Vapi27/GottFA80_PLuS/lib_common/R6532.vhd

-------------------------------------------------------------------------------
-- File       : R6532.vhd
-- Author     : Thierry DAVROUX
-- Company    : Flipprojets
-- Created    : 12-01-2017
-------------------------------------------------------------------------------
-- Description: Version simplifiee d'un 6532.
--              Avec uniquement les ports A et B et le timer.
--              La RAM et la ROM ne sont pas integrees dans ce module.
--              La selection est simplifiee avec un seul "Chip Select".
--              Detection de front sur PA7.
--              Bus d'adresses sur 5 bits (A4..A0).
-------------------------------------------------------------------------------
-- Copyright (c) Flipprojets François et Thierry DAVROUX - 2018
--               (contact@flipprojets.fr)
--
-- Concédée sous licence EUPL, version 1.2 ou – dès leur approbation par la
-- Commission européenne - versions ultérieures de l’EUPL (la «Licence»).
-- Vous ne pouvez utiliser la présente œuvre que conformément à la Licence.
-- Vous pouvez obtenir une copie de la Licence à l’adresse suivante:
--
-- https://joinup.ec.europa.eu/software/page/eupl
--
-- Sauf obligation légale ou contractuelle écrite, le logiciel distribué sous
-- la Licence est distribué «en l’état», SANS GARANTIES OU CONDITIONS QUELLES
-- QU’ELLES SOIENT, expresses ou implicites. Consultez la Licence pour les
-- autorisations et les restrictions linguistiques spécifiques relevant de la
-- Licence. 
-------------------------------------------------------------------------------
-- Revisions  :
-- Date        Version  Author   Description
-- 12-01-2017  1.0      TDX      Creation
-- 27-03-2017  1.1      TDX      Correction bug detection front PA7
-------------------------------------------------------------------------------

library  IEEE ;
use      IEEE.std_logic_1164.all ;
use      IEEE.numeric_std.all ;

entity  R6532 is
        port (
            phi2   : in  std_logic                     ; -- PHI2     horloge
            rst_n  : in  std_logic                     ; -- RST      reset negatif
            cs     : in  std_logic                     ; -- CS       chip select
            rw_n   : in  std_logic                     ; -- RW       read/write
            irq_n  : out std_logic                     ; -- IRQ      interruption
            
            add    : in  std_logic_vector (4 downto 0) ; -- A4..A0   Bus d'adresses
            din    : in  std_logic_vector (7 downto 0) ; -- DI7..DI0 Bus de donnees (entrees)
            dout   : out std_logic_vector (7 downto 0) ; -- DO7..DO0 Bus de donnees (sorties)
            
            pa_in  : in  std_logic_vector (7 downto 0) ; -- PORT A   entrees
            pa_out : out std_logic_vector (7 downto 0) ; -- PORT A   sorties
            pb_in  : in  std_logic_vector (7 downto 0) ; -- PORT B   entrees
            pb_out : out std_logic_vector (7 downto 0) ; -- PORT B   sorties

            -- ORA WRITE STROBE (added 2026-07-27 for SOUND_WIRE).  '1' for exactly
            -- the phi2-LOW half-cycle that follows a CPU write to ORA (register 0),
            -- i.e. it is high precisely while pa_out carries the value that write
            -- just produced -- pa_out is updated on the same falling_edge(phi2).
            -- This is the hardware strobe PinMAME uses (gts80.c riot6532_2a_w runs
            -- ONLY on a port-A write); without it a consumer of pa_out cannot tell
            -- "the CPU wrote the port" from "some other latch in the system moved".
            -- Purely additive: leave it unconnected (=> open) and it prunes away.
            -- A 6502 needs >= 3 phi2 cycles between two stores, so consecutive ORA
            -- writes always give separate pulses with a low phase in between.
            pa_wr  : out std_logic := '0'
        );
end entity;

architecture RTL of R6532 is

            signal s_ddra               : std_logic_vector (7 downto 0) ; -- Registre DDRA
            signal s_ddrb               : std_logic_vector (7 downto 0) ; -- Registre DDRB
            signal s_ora                : std_logic_vector (7 downto 0) ; -- Registre ORA
            signal s_orb                : std_logic_vector (7 downto 0) ; -- Registre ORB
            
            signal s_dout               : std_logic_vector (7 downto 0) ; -- Sortie du bus de donnees
            
            signal s_irq_timer          : std_logic                     ; -- Etat de l'interruption par le timer
            signal s_irq_timer_en       : std_logic                     ; -- Autorisation interruption par le timer
            signal s_divider            : unsigned (9 downto 0)         ; -- Prediviseur             (valeur maxi)
            signal s_count              : unsigned (9 downto 0)         ; -- Compteur du prediviseur (compteur)
            signal s_timer              : unsigned (7 downto 0)         ; -- Decompteur du timer     (valeur en cours)

            signal s_irq_pa7            : std_logic                     ; -- Etat de l'interruption par PA7
            signal s_irq_pa7_en         : std_logic                     ; -- Autorisation interruption par PA7
            signal s_edge               : std_logic                     ; -- Detection front sur PA7 (0 negatif, 1 positif)
            signal s_PA7                : std_logic                     ; -- Etat du PA7 memorise, pour detection front
            signal s_ora_wr             : std_logic := '0'              ; -- Ecriture dans ORA lors du dernier front montant de PHI2

begin

    ------------------------------------------------------------------------
    -- Fonctionnement principal dependant de PHI2
    ------------------------------------------------------------------------
    
    process(phi2)
    begin
    
        if (rising_edge(phi2)) then

            ------------------------------------------------------------------------
            -- Tout le circuit fonctionne sur front montant du PHI2
            -- y compris la prise en compte du RESET
            ------------------------------------------------------------------------

            s_ora_wr <= '0' ;                          -- defaut: pas d'ecriture ORA ce cycle

            if (rst_n = '0') then
            
                ------------------------------------------------------------------------
                -- RESET, init de la sortie de donnees et des ports A/B
                ------------------------------------------------------------------------
                s_dout          <= (others => '1')         ; -- Sortie FF
                s_ddra          <= (others => '0')         ; -- DDRA a zero
                s_ddrb          <= (others => '0')         ; -- DDRB a zero
                s_ora           <= (others => '0')         ; --  ORA a zero
                s_orb           <= (others => '0')         ; --  ORB a zero
                
                ------------------------------------------------------------------------
                -- RESET, init du timer/diviseur et du flag d'interruption
                ------------------------------------------------------------------------
                s_timer         <= (others => '0')         ; -- Remise a zero du decompteur du timer
                s_divider       <= "0000000000"            ; -- Remise a zero du prediviseur (mode 1T)
                s_count         <= (others => '0')         ; -- Remise a zero du compteur du prediviseur
                s_irq_timer     <= '0'                     ; -- Remise a zero de l'interruption
                s_irq_timer_en  <= '0'                     ; -- Interruption non autorisee
                
                ------------------------------------------------------------------------
                -- RESET, init du pa7 et du flag d'interruption
                ------------------------------------------------------------------------
                s_irq_pa7       <= '0'                     ; -- Remise a zero de l'interruption
                s_irq_pa7_en    <= '0'                     ; -- Interruption non autorisee
                s_edge          <= '0'                     ; -- Detection sur front negatif par defaut
            
            else
            
                ------------------------------------------------------------------------
                -- Traitement du timer, sur front montant du PHI2
                ------------------------------------------------------------------------
  
                if (s_count = s_divider) then
                    s_timer    <= s_timer - 1              ; -- On decremente le timer
                    s_count    <= (others => '0')          ; -- et on reinitialise le compteur du prediviseur
                    if (s_timer = "00000000") then           -- Si le timer est arrive a zero
                        s_divider   <= "0000000000"        ; --    on remet le diviseur a 1T
                        s_irq_timer <= '1'                 ; --    et on leve le flag d'interruption
                    end if ; 
                else
                    s_count <= s_count + 1                 ; -- On incremente le compteur du prediviseur
                end if ;
                
                ------------------------------------------------------------------------
                -- Traitement du PA7, sur front montant du PHI2
                ------------------------------------------------------------------------
  
                if (not(pa_in(7) = s_PA7)) then              -- Changement d'etat par rapport au dernier etat memorise
                    if (pa_in(7) = s_edge) then              -- Detection du front positif ou negatif selon programmation
                        s_irq_pa7 <= '1'                   ; -- Si oui, on leve le flag d'interruption pour PA7                        
                    end if ;
                end if ;
                s_PA7 <= pa_in(7)                          ; -- Memorisation de l'etat actuel du PA7
                
                ------------------------------------------------------------------------
                -- Acces aux registres, sur front montant du PHI2
                ------------------------------------------------------------------------
            
                if (cs = '1') then
                    -------------------------------------------------------------------------------
                    -- A condition que le CHIP SELECT soit actif, l'adressage est le suivant :   --
                    -- RW  xx000 - Read/Write    ORA                                             --  
                    -- RW  xx001 - Read/Write   DDRA                                             --
                    -- RW  xx010 - Read/Write    ORB                                             --
                    -- RW  xx011 - Read/Write   DDRB                                             --
                    --  W  1.100 - Write Timer    1T                                             --
                    --  W  1.101 - Write Timer    8T                                             --
                    --  W  1.110 - Write Timer   64T                                             --
                    --  W  1.111 - Write Timer 1024T                                             --
                    --  W  0x1.. - Write Edge Detect Control                                     --
                    -- R   xx1x0 - Read Timer                                                    --
                    -- R   xx1x1 - Read Status (interrupt flag)                                  --
                    -------------------------------------------------------------------------------
                
                    if (rw_n = '0') then
                        --------------
                        -- Ecriture --
                        --------------                  

                        if (add(2) = '0') then
                            ---------------------------------------------
                            -- Acces aux registres I/O    quand A2 = 0 --
                            ---------------------------------------------

                            case add(1 downto 0) is                       
                                when "00" =>
                                    ------------------------------
                                    -- 000 : Ecriture dans ORA  --
                                    ------------------------------
                                    s_ora    <= din ;
                                    s_ora_wr <= '1' ;   -- strobe d'ecriture ORA (voir port pa_wr)
                                when "01" =>
                                    ------------------------------
                                    -- 001 : Ecriture dans DDRA --
                                    ------------------------------
                                    s_ddra <= din ;
                                when "10" =>
                                    ------------------------------
                                    -- 010 : Ecriture dans ORB  --
                                    ------------------------------
                                    s_orb <= din ;
                                when "11" =>
                                    ------------------------------
                                    -- 011 : Ecriture dans DDRB --
                                    ------------------------------
                                    s_ddrb <= din ;
                                when others =>
                                    null ;
                            end case ;
                                
                        else
                            -------------------------------------------------
                            -- Acces aux registres Timer/Edge quand A2 = 1 --
                            -------------------------------------------------

                            if (add(4) = '1') then
                                ---------------------------------------------
                                -- Acces au timer/prediviseur quand A4 = 1 --
                                ---------------------------------------------

                                ---------------------------------------------
                                -- A3 active ou non les interruptions      --
                                ---------------------------------------------
                                
                                s_irq_timer_en <= add(3)     ; -- Autorisation des interruptions selon le bit A3
                                s_irq_timer    <= '0'        ; -- Efface le flag d'interruption
                                s_timer <= unsigned(din) - 1 ; -- Valeur initiale du timer
                                s_count <= (others => '0')   ; -- Mise a zero du compteur du prediviseur
                                    
                                case add(1 downto 0) is                          
                                    when "00" =>
                                        --------------------------
                                        -- 100 : diviseur    1T --
                                        --------------------------
                                        s_divider <= "0000000000" ; -- Valeur maxi du compteur = 0
                                    when "01" =>
                                        --------------------------
                                        -- 101 : diviseur    8T --
                                        --------------------------
                                        s_divider <= "0000000111" ; -- Valeur maxi du compteur = 7
                                    when "10" =>
                                        --------------------------
                                        -- 110 : diviseur   64T --
                                        --------------------------
                                        s_divider <= "0000111111" ; -- Valeur maxi du compteur = 63
                                    when "11" =>
                                        --------------------------
                                        -- 111 : diviseur 1024T --
                                        --------------------------
                                        s_divider <= "1111111111" ; -- Valeur maxi du compteur = 1023
                                    when others =>
                                        null ;
                                end case ;
                                
                            else
                                ---------------------------------------------
                                -- Acces au Edge              quand A4 = 0 --
                                ---------------------------------------------

                                ---------------------------------------------------------
                                -- A1 active ou non les interruptions                  --
                                -- A0 indique le sens de la transition                 --
                                ---------------------------------------------------------
                                
                                s_irq_pa7_en <= add(1)     ; -- Autorisation des interruptions selon le bit A1
                                s_edge       <= add(0)     ; -- Transition front positif ou negatif
                                s_irq_pa7    <= '0'        ; -- Efface le flag d'interruption                                
                            
                            end if ;
                                
                        end if ; -- Fin des ecritures --
                          
                    else
                        -------------
                        -- Lecture --
                        -------------
                          
                        if (add(2) = '0') then
                            ---------------------------------------------
                            -- Acces aux registres I/O    quand A2 = 0 --
                            ---------------------------------------------

                            case add(1 downto 0) is
                                when "00" =>
                                    ---------------------------
                                    -- 000 : Lecture de ORA  --
                                    ---------------------------
                                    s_dout <= ((s_ddra and s_ora) or (pa_in and not(s_ddra))) ; -- Lecture du port en entree ou des latches de sortie
                                when "01" =>
                                    ---------------------------
                                    -- 001 : Lecture de DDRA --
                                    ---------------------------
                                    s_dout <= s_ddra ;
                                when "10" =>
                                    ---------------------------
                                    -- 010 : Lecture de ORB  --
                                    ---------------------------
                                    s_dout <= ((s_ddrb and s_orb) or (pb_in and not(s_ddrb))) ; -- Lecture du port en entree ou des latches de sortie
                                when "11" =>
                                    ---------------------------
                                    -- 011 : Lecture de DDRB --
                                    ---------------------------
                                    s_dout <= s_ddrb ;
                                when others =>
                                    null ;

                            end case ;
                                                            
                        else
                            ---------------------------------------------
                            -- Acces au timer et status quand A2 = 1   --
                            ---------------------------------------------

                            if (add(0) = '0') then
                                ----------------------------------------
                                -- 1x0 : Lecture du TIMER             --
                                -- A3 active ou non les interruptions --
                                ----------------------------------------
                                s_irq_timer_en <= add(3)            ; -- Autorisation des interruptions selon le bit A3
                            
                                s_dout <= std_logic_vector(s_timer) ; -- Valeur courante du timer
                                if not (s_timer = "00000000") then
                                    s_irq_timer <= '0'              ; -- Efface le flag d'interruption du timer, sauf si interruption en cours
                                end if ;
                            else
                                -----------------------------
                                -- 1x1 : Lecture du STATUS --
                                -----------------------------
                                s_dout <= s_irq_timer & s_irq_pa7 & "000000"   ; -- Registre de status (flag d'interruption)
                                s_irq_pa7 <= '0'                               ; -- Efface le flag d'interruption PA7
                            end if ;
                      
                        end if ;
                                                                                  
                    end if ; -- Fin des lectures --
                          
                end if ; -- Fin des acces dependant du chip select --
                     
            end if ; -- Fin des traitements hors RESET

            ------------------------------------------------------------------------
            -- Signal d'interruption en sortie, si interruption generee et autorisee
            ------------------------------------------------------------------------
    
            irq_n <= not ((s_irq_timer and s_irq_timer_en) or (s_irq_pa7 and s_irq_pa7_en)) ;            
          
        end if ; -- Fin du traitement sur front montant de PHI2
                
        ------------------------------------------------------------------------
        -- Sorties sur les ports A et B, sur front descendant du PHI2
        ------------------------------------------------------------------------

        if (falling_edge(phi2)) then
            pa_out <= ((s_ora and s_ddra) or (pa_in and not(s_ddra))) ; -- Sortie sur PORT A, uniquement pour les bits en sorties (a "1" dans DDRA) + copie des entrees
            pb_out <= ((s_orb and s_ddrb) or (pb_in and not(s_ddrb))) ; -- Sortie sur PORT B, uniquement pour les bits en sorties (a "1" dans DDRB) + copie des entrees
            pa_wr  <= s_ora_wr ;                                        -- Meme front que pa_out => pa_wr='1' <=> pa_out porte la valeur qui vient d'etre ecrite
        end if ;
     
    end process ;
    
    ------------------------------------------------------------------------
    -- Sortie sur le bus de donnees
    ------------------------------------------------------------------------
    
    dout <= s_dout when ((cs = '1') and (rw_n = '1')) else (others => '1') ; -- Si lecture et chip select, sinon FF

end architecture;
