Vapi27/GottFA80_PLuS/(commit log)

2026-06-04 Initial commit: GottFA80_PLuS FPGA project
    Includes Cyclone 10 and Cyclone IV v4 project directories plus
    shared libraries (lib_common, lib_cyclone_10, lib_cyclone_IV).
    [SYS80.smp_dump.txt]
2026-06-04 lisyctrl + nor_flash for GottFA80_PLuS (Cyclone 10) — GHDL-validated
    GPL-3.0 additions: lib_common/spi_slave.vhd (CS-less SPI mode-0 slave), lib_common/lisyctrl.vhd (diagnostic SPI register file: switch scan, lamp/coil/display control, coil safety watchdog), lib_common/nor_flash.vhd (drop-in for SD_Card, reads the 16KB game image from SPI NOR). sim/ GHDL testbenches all pass against lib_common, incl. sys80_glue integration test of the shared-bus inout mechanism. SYS80 integration + SPI register map in LISYCTRL.md; NOR swap in NOR_FLASH.md. Diagnostic mode shares the SD/EEPROM SPI bus (FPGA tri-states MOSI/CLK/MISO, acts as SPI slave; 6502 held in reset). Matches the real Cyclone 10 pinout.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
    [lisyctrl.vhd, nor_flash.vhd, spi_slave.vhd, sys80_glue.vhd, tb_integration.vhd, tb_lisyctrl.vhd, tb_nor_flash.vhd]
2026-06-04 Integrate lisyctrl into SYS80 (Cyclone 10) + .qsf
    SYS80.vhd: MOSI/CLK/MISO -> inout (shared-bus slave mode); lisyctrl instance + bus arbitration (tri-state CLK/MOSI, drive MISO, deselect SD/EEPROM, hold 6502 in reset) gated by lisy_active; output muxes for U6_PA/U6_PB + U4_PB strobes reuse the existing pin conditioning. .qsf: add spi_slave.vhd + lisyctrl.vhd. lisy_active defaults '0' => behaviour identical to stock; mode-entry trigger left for review. Standalone modules + glue are GHDL-validated in sim/; the full top needs Quartus (Altera megafunctions).
    [SYS80.vhd]
2026-06-04 lisyctrl mode entry: long-press of the Gottlieb door test switch
    detect_test_sw long_push (door test switch, strobe0/return7) latches lisy_active; reset/reboot (reset_l='0') clears it. Active from attract/idle. Replaces the lisy_active='0' placeholder; LISYCTRL.md updated.
    [SYS80.vhd]
2026-06-04 Document Quartus 22.1 toolchain validation (synth/fit/timing + resource delta)
    Full flow passes for 10CL006YE144C8G on Quartus Prime Lite 22.1std.0 (915):
    A&S 0 err, Fitter 0 err, Assembler 0 err -> SYS80.sof, STA timing met
    (setup +4.94ns, hold +0.40ns). lisyctrl costs +522 LEs (83%->91%),
    zero new pins, zero new memory; MOSI/MISO/CLK return to pins 42/34/39 as
    bidirectional. Validated on an isolated x86_64 build host.
2026-06-04 Add lisy_enable generic to compile out the diagnostic bridge
    Default true (unchanged behaviour). Set false to exclude lisyctrl+spi_slave
    entirely, recovering ~522 LEs (91%->83% on 10CL006); the shared-bus arbitration
    muxes constant-fold back to stock SD/EEPROM behaviour (lisy_active='0').
    VHDL-93 if-generate, mutually exclusive -> single driver per signal.
2026-06-04 Integrate lisyctrl into the Cyclone IV variant (EP4CE6E22C8)
    Same integration as the Cyclone 10 build, applied via patch (the two SYS80.vhd
    are identical RTL; only device/megafunction libs differ). lisy_enable generic
    included. .qsf gains spi_slave.vhd + lisyctrl.vhd. Keeps the variant's own
    version strings.
2026-06-04 Note dual-target validation: Cyclone 10 LP + Cyclone IV E both pass full flow
2026-06-04 Wire Debug pin to lisy_active (ESP bus-grant handshake)
    The ESP companion polls Debug to know when diag mode is active and the shared
    SPI bus has been released to it (FPGA = SPI slave). Debug was previously an
    undriven/stuck-GND output. Both variants. lisy_enable=false => Debug<='0' (stock).
    [SYS80.vhd]
2026-06-05 Coil thermal/duty protection + fault reg, and lisyctrl->gosof80 sound path
    lisyctrl: per-coil pulse clamp (max_pulse_ms), re-fire cooldown (refire_ms), and a
    watchdog-with-coil latch -> COIL_FAULT reg 0x32 (read; write clears). New SOUND reg
    0x44 drives a 5-bit System 80 sound code + a level trigger held sound_hold_ms.
    gosof80: optional lisy_active/lisy_sound/lisy_trig inject -> DFcmd_par2 + send_flag,
    and keep the DFPlayer out of reset in diag mode (CPU held). All gated by lisy_active
    (default off => stock). SYS80 (both variants): wire o_sound/o_sound_trig -> gosof80.
    Validated: ghdl tb_lisyctrl ALL PASS; Quartus both targets map/fit 0 err, timing met
    (C10 setup +4.74ns); C10 5,801 LE (92%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
    [GOSOF80.vhd, SYS80.vhd, lisyctrl.vhd]
2026-06-05 AY-3-8910/8912 PSG core (System 80B / System 3 sound) + 80B analysis
    New GPL VHDL core: 3 tone channels + noise (17-bit LFSR) + envelope (8 shapes) +
    per-channel mixer + 4-bit log amplitude DAC + summed audio. Self-checked testbench
    (ghdl) -> 'AY TESTS PASSED' (added to sim/run_all.sh).
    SOUND_80B.md documents the 80B sound state + roadmap and the key FIT finding:
    one AY = 456 LE; a faithful late-80B board (2x AY + sound 6502 + glue ~3,200 LE)
    does NOT fit the 10CL006 (5,801/6,272 used, ~470 free) -> needs a bigger FPGA, or
    the MP3/sample route on the 10CL006. Core not yet instantiated in SYS80 (library
    component for the 80B/System 3 work, to coordinate with bontango).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
    [ay_3_8910.vhd, tb_ay_3_8910.vhd]
2026-06-05 SOUND_80B: GOSOWAV (WAV-sample) decided as the 10CL006 path + RE of the 80B command interface
    PinMAME RE: 80B sound command = 5-bit (nibble+1, strobed), already captured as
    Sound_Meta; board = 2x6502 + DAC + SP0250 + AY-8913/AY-3-8912 or YM2151. GOSOWAV
    needs no chip emulation -> fits the 10CL006. AY core repositioned to faithful route.
2026-06-05 sound_link: 1-wire FPGA->ESP UART carrying the live sound# + game# (for GOSOWAV)
    Lets the ESP WAV player pick the per-game theme folder and play <theme>/<sound>.wav.
    One self-describing 8N1 byte per event: 0x80|sound[4:0], 0x40|game[5:0] (ranges never
    overlap). Self-checking testbench (ghdl) -> SOUND_LINK TESTS PASSED (game 0x43, sound
    0x85); added to run_all.sh. Not yet wired into SYS80 (needs the FPGA TX pin decision).
2026-06-05 Doc: FPGA->ESP sound link wiring + the 10CL006 pin/LE constraint
    sound_link fits the Cyclone IV (93% LE) but not the 10CL006 as a NEW pin (out of
    output pins, I/O bank 5 overflow; LE 97%). On the 10CL006 reuse PIN_2 (Audio_RX /
    DFPlayer UART) for sound_tx -- free when the ESP/GOSOWAV replaces the DFPlayer.
2026-06-05 esp_sound + Debug-merge: ESP/GOSOWAV sound on one wire (drop GOSOF80+DFPlayer)
    Adds the `esp_sound` generic (default false = stock). When true, the FPGA's own
    sound (GOSOF80 + DFPlayer driver) is dropped and a single 8N1 UART on the Debug
    pin (PIN_11 / K2) carries everything the ESP needs: a diag-mode token (0xF0/0xF1
    plus a 50 ms heartbeat) and the live sound#/game# (0x80|s, 0x40|g). Diag and
    gameplay sound never overlap (the 6502 is held in diag), so one wire serves both;
    PIN_2 (Audio_RX) and PIN_7 (Sound) are freed and no new pin is used.
    - sound_link.vhd: + diag input, mode token, heartbeat.
    - SYS80 (C10 + IV): GEN_ESP_SND drives Debug <= sound_link tx; GEN_DBG_LVL keeps the
    level han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
2026-06-06 Tournament FPGA feature: time-attack display + free-game solenoid block
    New sim-verified VHDL modules (ghdl, all in sim/run_all.sh):
    - tourney_countdown: time-attack score timer (1M, -10K/s, clamp 0, dead)
    - bin_to_bcd + value_to_dispstr: countdown value -> 7-char display string
    - tourney_display_top: bundles tick-gen + countdown + string for SYS80
    - tourney_block: suppress a free-game solenoid (knocker) when armed
    Integration (OFF-BY-DEFAULT via tournament_mode='0' = stock behaviour):
    - lisyctrl.vhd: CTRL2 reg 0x04 b0 = tournament_mode, latched (persists past
    diag exit into gameplay), read-back + o_tournament port
    - SYS80.vhd (Cyclone 10): instantiate the chain, draw the countdown on the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
2026-06-06 Tournament auto-timer: game-state on the FPGA->ESP link (0xF2/0xF3)
    sound_link.vhd: new game-state message (0xF2 over / 0xF3 running) sent on
    game_running edges + heartbeat, alongside the existing diag/sound/game tokens
    (non-overlapping ranges). Lets the ESP auto-start/stop the time-attack clock
    with no manual input. tb_sound_link: covers 0xF3/0xF2 (sim 10/10).
    SYS80.vhd (Cyclone 10): game_running => sound_link; also use a dedicated
    ta_rst <= not reset_l signal for tourney_display_top (ghdl rejects an
    expression actual in a port map; functionally identical).
    [SYS80.vhd, sound_link.vhd, tb_sound_link.vhd]
2026-06-06 Hybrid sound build: GOSOF80 synth + sound_link to the ESP (off by default)
    New SYS80 generic `hybrid` (default false; requires esp_sound=false). In a hybrid
    build GOSOF80 stays the sound source for the games it supports (80/80A + early 80B)
    AND the sound_link UART feeds the ESP on the Debug pin, so the ESP plays only what
    GOSOF80 can't (speech + the complex 80B) via sndmode=hybrid / sndroute.
    - GEN_HYB_LINK: instantiates sound_link -> Debug (only the Debug pin; GOSOF80 keeps
    Sound/PIN_7 + the now-unused DFP_tx/PIN_2). `and not esp_sound` guards a both-true
    misconfig so Debug never gets two drivers.
    - GEN_DBG_LVL now gated `(not esp_sound) and (not hybrid)` (the link carries the diag
    t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
2026-06-07 Option B: disp_inject — ESP->FPGA display UART for the time-attack countdown
    The ESP computes + FORMATS the countdown digits and streams them to the FPGA, so the
    FPGA countdown+BCD chain (~463 LE: tourney_countdown + bin_to_bcd + value_to_dispstr)
    can be replaced by a tiny UART RX — and the ESP handles the 7-seg (80/80A) vs 16-seg
    (80B) formatting in software.
    disp_inject.vhd: UART RX (8N1) + frame decode [0xFF sync + 7 ASCII chars] -> latches
    `dstr` + raises `arm` (a drop-in for tourney_display_top's arm+dstr, fed to boot_message).
    `arm` self-clears on a receive timeout (ESP stops sending at game over). tb_disp_inject
    covers frame decode, value update, and timeout. Sim suite 11/11.
    Ch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
    [disp_inject.vhd, tb_disp_inject.vhd]
2026-06-07 Option B wiring: disp_inject into SYS80 (C10) — ESP-driven time-attack display
    Replaces the FPGA-autonomous TADISP countdown chain (~463 LE) with the ESP-driven
    disp_inject whenever an ESP is present (hybrid or esp_sound):
    - Audio_RX/PIN_2: buffer -> inout. Stock build still drives it as the DFPlayer TX
    (GOSOF80 DFP_tx -> internal dfp_tx_sig -> Audio_RX via GEN_DFP_DRV); when an ESP is
    present it's tristated (GEN_RX_IN) so the ESP drives it -> disp_inject rx.
    - GEN_DISPINJ (esp_sound or hybrid): disp_inject -> ta_arm + ta_dstr (the display mux is
    unchanged). GEN_NODISP (stock): ta_arm='0' (no overlay, identical to before — stock has
    no companion to arm it anyway).
    - Exactly one A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
    [SYS80.vhd]
2026-07-27 Pstore: NOR boot, System-80 display + diag fixes, RAM snapshot tool, time-attack
    Work proven on a real Gottlieb Volcano (System 80) on 2026-07-25/26.
    FPGA (SYS80.vhd + lib_common):
    - nor_flash: game ROM boots from an external SPI NOR instead of the microSD.
    - Display: force not80B (the stock 16-edge auto-detect never fired on this
    machine), route lisyctrl to the numeric glass in diag, blank the unused
    player rows under the overlay.
    - Diag entry: drop the U5_pb_out(7) gate on the door test switch — System 80
    parks that line in the DIP-read state, so the long-press was never seen.
    - disp_inject: ESP->FPGA control/display UART on PIN_2 (Audio_RX turned into a
    real input; it used to b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
    [SYS80.smp_dump.txt]
2026-07-27 Family decode: one bitstream for System 80 / 80A / 80B
    Foundation for multi-family support. The build was System-80-only by
    construction (`not80B <= '1'` hard-wired); the family is now decoded from the
    game number the operator already sets on DIP S1, registered the instant the
    DIP scan finishes -- i.e. known before the 6502 fetches its reset vector, from
    positive evidence, and stable. The upstream COUNT_STROBES auto-detect is
    deliberately NOT restored: it infers 80B from the ABSENCE of strobes, is a
    one-way latch, and powers up in the wrong state.
    NEW lib_common/gts_family.vhd -- pure-function package, ~6 LE of comparators:
    f_is_80 / f_is_80A / f_is_80B / f_has_7digit / f_late_80B.
    sim/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
    [SYS80.vhd, gts_family.vhd, sound_link.vhd, tb_gts_family.vhd]
2026-07-27 Sound wire: report bus EVENTS, not bus levels (SOUND_WIRE.md, FPGA half)
    The link told the ESP what the sound BUS LOOKED LIKE. It now tells it what
    the 6502 DID. Four defects, each verified in source and each demonstrated in
    simulation against the code burned in the machine today.
    1. COALESCING. sound_link kept ONE pending command in ONE register, re-armed
    combinationally every clock, emitting at most one byte per 86.8 us slot.
    A 6502 rewrites the latch 4.5 us later, so an 80B header/payload pair
    collapsed into a single byte and the bank was lost SILENTLY.
    -> an 8-entry x 6-bit FIFO {rel, code[4:0]}, drained one entry per grant,
    in order. Storage carries ramstyle="M9K":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
    [R6532.vhd, SYS80.vhd, snd_bus.vhd, tb_snd_wire.vhd]
2026-07-27 Fix three audited FPGA defects: detect_sw stuck pulse, ta_overlay digit map, SDC scope
    1. lib_common/detect_sw.vhd -- the delay state wrote "long_push <= '0'" TWICE and
    never cleared short_push, so after the first press of >=20 ms short_push
    latched high for the rest of the power cycle. Only consumer is
    detect_test_sw.short_push = test_sw -> EEprom w_trigger(2); the EEprom block
    saves the 5101 NVRAM on any CHANGE of w_trigger, so "press the door test
    switch to commit the settings" fired exactly once per power-up and never
    again. long_push (-> lisy_trig, diag entry) was already correct and is
    unchanged. New sim/tb_detect_sw.vhd asserts the pulse contract and counts the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
    [SYS80.vhd, boot_message.vhd, detect_sw.vhd, ta_overlay.vhd, tb_detect_sw.vhd, tb_ta_overlay.vhd]
2026-07-30 Freeze FPGA v1: reproducible build, dead-code audit, GPL compliance
    No logic change. Proven by construction: the .rbf produced from this tree is
    BYTE-IDENTICAL to the one produced from the previous commit
    (sha256 327e658fb38e8e9ed2008e6bd085bf35a839b89f477fd15c3e493a33267f1b4f),
    and the fitter reports the same 4,815 LE / 4,477 comb / 2,113 reg / 375 LAB /
    18 M9K and the same timing slacks to the picosecond.
    DEAD CODE REMOVED (all verified unread before deletion)
    SYS80.vhd Counter declared 2020, never referenced
    ta_value/ta_dead/ta_rst
    leftovers of the tourney_display_top chain that was
    dropped when the countdown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
2026-08-20 CONNECT: trame CONTROL2 0xFD -> entree/sortie diag par lESP, et retour au boot SD
    disp_inject: troisieme type de trame 0xFD + octet de drapeaux. Linvariant de
    resynchro tient : toutes les charges utiles existantes sont bornees a 0x7E, donc
    elargir la plage de marqueurs de 0xFE a 0xFD ne casse aucun emetteur.
    ctrl2(0) = demande de diag, en NIVEAU (pas en front) -> CONNECT et DISCONNECT.
    Garde-fou propre au module : ctrl2 efface apres 5 s de silence de lESP, donc un
    ESP plante ne peut pas laisser le 6502 gele et la machine morte.
    SYS80: lisy_active prend une seconde entree. lisy_by_esp retient par quelle porte
    on est entre, pour quun ESP muet nannule pas une session ouverte au contacteur.
    Le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
2026-08-28 Corriger le nom dans les en-tetes de copyright
    « Valere Pilpil » au lieu de « Valere Pillet » dans huit fichiers. La meme
    coquille figurait dans le NOTICE de gottfa-bitstreams : un en-tete de licence
    qui nomme mal son auteur affaiblit la chaine de droits quil est cense etablir.
    [GOSOF80.vhd, GOSOF80_096.vhd, bin_to_bcd.vhd, disp80b_diag.vhd, tourney_block.vhd, tourney_countdown.vhd, tourney_display_top.vhd, value_to_dispstr.vhd]
2026-08-28 Bancs de simulation : equivalences memoire et arbitrage du lien
    tb_link_arb etendu (+407 lignes) et run_all.sh refondu (+127). Dix bancs neufs,
    dont cinq dequivalence memoire -- GAME_ROM, R5101, RIOT_RAM, SB_RAM,
    SYSTEM_ROM -- qui comparent le modele portable au modele Altera dorigine.
    Cest ce qui permet de changer de cible sans le decouvrir a la synthese.
2026-08-28 Portage Spartan-6 : primitives memoire independantes du fondeur
    lib_portable/ reecrit les cinq blocs memoire sans primitive Altera, pour que le
    meme RTL puisse viser un Spartan-6. Les bancs dequivalence du commit precedent
    existent precisement pour prouver que la reecriture ne change rien.
    FAISABILITE_SPARTAN6.md et INSTALL_ISE.md consignent ce qui a ete etabli et la
    mise en place de la chaine ISE.
2026-08-28 Recuperer de `lisyctrl` les sept bancs orphelins et les deux documents
    LA FUSION DEMANDEE N'A PAS LIEU D'ETRE, et c'est le resultat principal de
    cette verification. Les nnn commits que `lisyctrl` a en propre ont deja leur
    CONTENU dans `spartan6-feasibility` : coeur AY-3-8910 (fichier identique au
    bit pres), protection thermique des bobines, temps mort anti-mitraillage,
    registre de faute, generique `lisy_enable`, `sound_link`, `disp_inject`,
    chrono time-attack, poignee de main Debug -- et les deux variantes Cyclone.
    Verifie marqueur par marqueur, pas au jugement.
    Fusionner aurait donc traine des artefacts Quartus (atom_netlists, greybox_tmp,
    .qws), un SYS80.vhd.bak et un SYS80_beta.vhd de 91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
2026-09-01 Spartan-6 : boot NOR, generics de banc, temoins de vie — prouve sur deux machines
    - GEN_SD/GEN_NOR par generic use_sd (les deux chargeurs restent analyses) ;
    branche NOR : selection FP = slot+64 comme l'amont, /CS via NOR_CS_FPGA (P35,
    tri-state des que le bus ne nous appartient plus), i_Rst_L integre esp_bus.
    - bench_game (jeu force, DIP contournees) et bench_opts (options neutres) :
    au banc sans faisceau, les retours flottants donnent un numero ET des options
    aleatoires — game_option(5) inverse a elle seule la famille 80B (fam_ovr).
    - Temoins de banc sur les LED (actives bas) : LED_ON = etireur d'IRQ 165 ms
    (allumee = le 6502 vit), LED_Int = not reset_l (allumee = CPU relache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
    [SYS80.vhd]
2026-09-01 game_beacon : le FPGA annonce a l'ESP le jeu reellement charge
    Trame de 4 octets a 115200 bauds, 2x/s, sur P142 -> GPIO18 (UART1 RX de
    FA_Control) : 0xFA, "0"&fp&gnum(5:0), flags (game_running, is_80B, is_80A,
    reset_l), xor^0xA5. Le bit 7 de l'octet jeu vaut toujours 0 : la synchro ne
    peut pas etre imitee par une donnee. Le fil etait cable au PCB depuis
    toujours ; c'est la premiere fois que l'entite s'en sert (port esp_link_tx).
    Prouve de bout en bout : /api/beacon rend {jeu:13, fp:true, running:true,
    famille:80} — et revele au passage que les DIP du Volcano etaient sur 13
    (sound-only) et non 12 (speech), ce qui expliquait le son "different".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
    [SYS80.vhd, game_beacon.vhd]
2026-09-05 construire_spartan6.sh : les bitstreams Spartan redeviennent reconstructibles
    Les .svf de gottfa-bitstreams/spartan6/ n'etaient reproductibles PAR PERSONNE :
    aucun script ne les produisait, et le seul brochage existant
    (gottfa-hw/pinout/GottFA80_SLX9.ucf) n'etait reference nulle part. On ignorait
    donc avec quels generics ils avaient ete batis -- or ce sont eux qui decident du
    chemin d'affichage, de la source du jeu et du mode son. Ce trou a coute du temps
    sur l'afficheur ce matin.
    Le .ucf est copie ici parce que l'hote ISE ne recoit que ce depot ; l'original
    vit dans gottfa-hw/pinout/ et reste la reference.
    TROIS PIEGES PAYES EN L'ECRIVANT, tous desormais traites par le script :
    - lib_co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
2026-09-05 Relais audio : les voix de l'ESP sortent par l'etage audio de la porteuse
    LE PROBLEME. Le module Smart FA n'a AUCUN etage audio -- ni DAC, ni ampli, aucun
    net I2S dans les six feuilles du schema. Le firmware ESP emettait donc son I2S
    sur GPIO17/18, qui portent en realite ESP32_TX / ESP32_RX vers le FPGA, dont
    l'une est une SORTIE du FPGA : deux pilotes sur un fil, et un son « ultra
    faible » qui n'etait que de la fuite.
    Or l'etage existe deja de l'autre cote. La broche Sound (P44) porte le flux
    delta-sigma vers le filtre RC 3k3/4n7 de la porteuse puis le TDA7267 ; sans
    GOSOF80 elle etait simplement mise a '0'. On la reprend.
    LE FIL : ESP GPIO17 -> FPGA P143, deja cable (gottfa-hw/ETAT.md: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
    [SYS80.vhd, audio_uart.vhd]
2026-09-08 SC-01 : deux fautes qui tuaient l'attract des jeux a parole
    Symptome : en attract, 2-3 lampes puis plateau noir ; en partie tout est
    parfait, le son sort. Frappait Mars (10), Volcano (12) et Black Hole (14) ;
    Devil's Dare, Rocky et Volcano-13 (sans parole) etaient intacts.
    1. Votrax-SC01.vhd -- index de phoneme SIGNE.
    time_map(to_integer(signed(cpu_data))) : cpu_data fait 6 bits, time_map est
    un tableau 0 to 63. `signed` les lit de -32 a +31 : tout phoneme dont le
    bit 5 est a 1 -- LA MOITIE DU JEU -- donnait un index NEGATIF, hors bornes.
    La duree devenait quelconque et AR restait bloque a « occupe ». Sur MA-216,
    AR pilote riot_pb_i(7) ET le NMI du processeur son.
    2. GOSOF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
2026-09-10 P141 : 100 ms au lieu d'1 ms ; voix dans l'attract ; NVRAM a deux bancs
    SYS80.vhd -- le correctif de la soiree. Le FPGA acceptait 1 ms de niveau bas sur
    FA_CTRL_REQ (P141) comme une demande de prise de controle. Un redemarrage de l'ESP
    produit ce creux, et ouvrir le port serie redemarre l'ESP : lisy_active passe a '1',
    cpu_res_n tombe a '0', les lampes sont rendues a lisyctrl qui est muet -- machine
    figee, plateau noir. Prouve au banc le 2026-09-10 en trois gestes : reset physique,
    elle vit ; 90 s sans lui parler, elle vit toujours ; une commande de lecture, elle
    fige. Seuil porte a 100 ms, avec un prescaler SEPARE : ctrl_pre comptait jusqu'a
    ctrl_low_max, donc allonger le seuil sans le diss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
    [EEprom.vhd, GOSOF80.vhd, SYS80.vhd]
2026-09-10 Menage : le code mort de l'observation, et deux ports qui mentaient
    Trois choses laissees par la chasse au defaut de P141, dont deux etaient des pieges.
    La chaine d'observation est morte depuis le 8 septembre. `ctrl_line_obs` promettait
    « observer P141 sans le brancher », mais le port de la balise qui recevait le resultat
    avait ete reaffecte le meme jour : `ctrl_obs`, `ctrl_obs_s` et `ctrl_low_seen` etaient
    calcules pour personne. Un parametre qui ment sur ce qu'il fait coute plus cher qu'un
    parametre absent -- supprimes.
    `ctrl_lvl` et `ctrl_low_seen` de game_beacon portent les temoins de vie du 6502 depuis
    le 8 septembre, sous des noms qui parlent encore de P141. Renommes en `cpu_alive`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
2026-09-11 L'instantane memoire n'a jamais tourne en hybride : il etait dans la mauvaise branche
    RAM_SNAP -- l'instance qui PRODUIT la trame d'instantane -- etait enfermee dans
    GEN_ESP_SND, donc absente des que esp_sound=false, c'est-a-dire dans la configuration
    meme de la carte Smart FA. Les cinq lignes qui captent les ecritures du 6502
    (snap_riot_wr, snap_5101_wr, snap_wr_en, snap_wr_addr, snap_wr_data) y etaient aussi.
    Consequences, toutes mesurees le 2026-09-10 : aucun marqueur 0xBF ni quartet sur le
    lien en 25 s ; snap_req a '0' en permanence, donc XST elaguait snap_ack a une constante
    (« FF/Latch <snap_ack> has a constant value of 0 ») et declarait lamp_ack_s sans
    charge ; ram_snoop n'etait me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
    [SYS80.vhd]
2026-09-11 Espion d'afficheur 80B : ecrit, et desactive parce qu'il coupe le lien
    Le miroir du verre fonctionne sur System 80/80A -- mesure : « P1 000000 P2 000000 ».
    Sur 80B il ne pouvait pas fonctionner : le verre y est ALPHANUMERIQUE, le 6502 pose un
    octet en deux quartets dans deux verrous puis le pousse dans une ligne par une impulsion
    LD. L'espion 7 segments n'en dit rien, et le decodeur ASCII de glassview.c recevait donc
    des motifs de segments -- il rendait « F. G. F. » (constate au banc, DIP mis sur un titre
    80B). C'est exactement le piege que lisy.h documente.
    L'espion 80B est ecrit et suit le protocole de l'en-tete de lib_common/disp80b_diag.vhd,
    qui l'ECRIT en diagnostic (verifie la co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
2026-09-11 Espion 80B : trois pistes eliminees, la cause reste introuvable
    L'espion tue le lien FPGA->ESP -- zero octet, balise comprise -- sans la moindre erreur
    de synthese. Bissection de ce soir, trois pistes ecartees par la mesure :
    1. LE MULTIPLEXEUR DE FAMILLE. Le lien meurt AUSSI en System 80, ou le mux ignore
    completement cet espion. Ce n'est donc pas la selection.
    2. LE CHEMIN D'ECRITURE. Une variante ou le process lit tout mais n'ecrit JAMAIS
    (d80_wr_en force a '0') tue le lien pareillement.
    3. LA LECTURE DE U5_pa_out(4)/(5). J'ai cru y voir des horloges de verrous : faux, les
    sn74175 sont synchrones sur clk_50 et ces entrees sont des donnees. Mieux : ces memes
    verrous capturent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
    [SYS80.vhd]
2026-09-11 README : ce depot n avait pas de porte d entree
    Il est public et c est un fork GPL : la premiere chose a dire est a qui appartient le
    travail. L essentiel de la structure est celui de bontango, le NOTICE le detaille
    fichier par fichier -- le README y renvoie au lieu de le paraphraser -- et ce que
    Pstore ajoute est liste a part, sans ambiguite.
    Le reste est ce qu on aurait voulu lire en arrivant : la commande de construction avec
    l avertissement use_sd=false en rouge (sans lui la carte est muette alors que la LED dit
    qu elle est programmee), le tableau des generics qui decident du comportement, et les
    cinq pieges mesures sur materiel -- le seuil P141 d une milliseconde, l espion qui
    entretie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
2026-09-11 Le miroir du verre 80B fonctionne : deux causes, trouvees par bissection
    « @ IGH GAMES TO DATE » -- le verre d'un 80B, lu par le FPGA et decode par l'ESP. Il y
    avait DEUX causes au lien mort, et aucune ne se voyait a la synthese.
    1. LIRE `U5_pb_out` AU LIEU DE `u5pb_disp`. Un process qui ne fait QUE
    `d80_ld1_d <= U5_pb_out(4)` -- rien d'autre, ni compteur ni ecriture -- tue le lien :
    zero octet, balise comprise. Le meme process sur `u5pb_disp`, deja derive et utilise
    par le chemin d'affichage, laisse le lien intact. `U5_pb_out` sort du RIOT cadence par
    cpu_clk ; y ajouter une charge depuis un process a 50 MHz casse quelque chose que
    « All constraints were met » ne voit p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
2026-09-11 Miroir 80B : deux defauts de plus, et le texte devient propre
    « HIGH GAMES TO DATE » sans parasite, la ou il y avait « @. HIGH GAMES TO DATE » puis,
    avant cela, un melange illisible.
    LA COLLISION D'ADRESSES. J'avais ecrit dans le commit precedent que les deux espions
    « visent des indices qui ne se recouvrent pas » -- c'est FAUX et je le corrige : System 80
    ecrit 768..815, 80B ecrit 768..807. Ils se marchent dessus sur toute la plage, d'ou des
    octets melanges et du 7 segments decode comme de l'ASCII (« F. . OOO.OOO »). Chacun se
    tait desormais selon la famille, mais DANS SON PROCESS : la condition porte sur
    l'ecriture, pas sur un multiplexeur externe -- c'est ce dernier qui tuait le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
    [SYS80.vhd]
2026-09-11 Instantane : une trame toutes les 400 ms au lieu d'une par seconde
    Le miroir du verre se rafraichissait une fois par seconde, et c'etait la cadence du FPGA
    qui limitait -- pas le lien.
    Le calcul qui fixe la borne : une trame fait 1 + 692*2 = 1385 octets, soit 120 ms a
    115200 bauds. A 400 ms, le lien est occupe 30 % du temps ; il en reste largement pour la
    balise et les codes son, ou l'instantane est de toute facon en derniere priorite.
    MESURE APRES, sur carte : la balise reste fraiche -- age_ms entre 88 et 320 ms, valide=1
    sans interruption. Rien n'est etouffe.
    ⚠️ Ne pas lire le partage du lien en OCTETS : une trame d'instantane ecrase en volume les
    quelques dizaines d'octets de la ba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
    [SYS80.vhd]
2026-09-11 Sortir du suivi les 16 bancs d essai COMPILES
    18 Mo de binaires Mach-O arm64 versionnes dans un depot de sources VHDL.
    `sim/run_all.sh` les reconstruit depuis le VHDL : ils changent a chaque
    simulation, ce qui laissait l arbre sale en permanence et faisait
    apparaitre « 16 fichiers modifies » sans qu aucune source ait bouge.
    Les sources des bancs (sim/tb_*.vhd) restent versionnees, evidemment.
    Seuls les executables partent.
2026-09-11 Dire pourquoi l ESP ne pourra jamais relire la NOR des jeux
    Commentaire seul, aucun changement de comportement.
    MOSI et CLK se taisent sur (lisy_active or esp_bus). MISO ne connait pas
    esp_bus : elle est PILOTEE des que lisy_active vaut '1', puisque c est la
    ligne de retour de lisyctrl.
    Mesure du 2026-09-11, chaque ligne lue sous rappel haut puis sous rappel
    bas -- une ligne libre suit le rappel, une ligne pilotee l ignore :
    hors diag : MOSI et CLK tenues par le FPGA, MISO libre
    en diag : MOSI et CLK libres, MISO TENUE HAUTE par lisy_miso
    Aucun etat ne donne les quatre lignes a l ESP. D ou le fait, reste
    inexplique depuis le 31/08, que l ecriture de la NOR marche (elle n a pas
    b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
    [SYS80.vhd]
2026-09-11 Correctif MISO + registre lisyctrl 0x33 BUSREQ
    L'ESP pouvait ECRIRE la NOR des jeux et jamais la relire. MOSI et CLK se
    taisent sur (lisy_active or esp_bus) mais MISO etait PILOTEE des que
    lisy_active valait '1' : c'est la ligne de reponse de lisyctrl. Aucun etat
    ne donnait les quatre lignes a l'ESP, et le 0xFF relu etait notre propre
    lisy_miso au repos -- pas une NOR muette.
    SYS80.vhd
    esp_bus <= '1' when (reset_sw_stable = '0' or lisy_bus_grant = '1')
    MISO <= 'Z' when esp_bus = '1' else lisy_miso when lisy_active = '1' ...
    esp_bus passe DEVANT lisy_active : une cession demandee doit l'emporter
    sur l'usage par defaut.
    lib_common/lisyctrl.vhd
    W 0x33 BUSREQ, valeur magique 0x5A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
    [SYS80.vhd, lisyctrl.vhd]
2026-09-11 La cession du bus s'annulait elle-meme : separer bus_a_esp de esp_bus
    Le correctif precedent faisait du registre 0x33 une source de `esp_bus`.
    Or `esp_bus` remet nor_flash en reset -- et un nor_flash en reset baisse
    cpu_reset_l, donc reset_l, et la l.1388 efface `lisy_active` des que
    reset_l vaut '0'. lisyctrl effacait alors `grant`, esp_bus retombait, et
    nor_flash RECHARGEAIT la ROM en pilotant MOSI/CLK. La sonde voyait
    « MOSI et CLK tenus bas » et accusait le FPGA d'avoir garde le bus, alors
    qu'il venait de le reprendre a cause de la demande elle-meme.
    Deux signaux distincts desormais :
    esp_bus voie HISTORIQUE (machine en reset). Elle seule reinitialise
    nor_flash -- c'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
    [SYS80.vhd]
2026-09-11 AVERTISSEMENT : le correctif MISO/BUSREQ tue l'attract du plateau
    Commentaire seul. L'arbre tel quel ne doit pas etre regrave : la lecture
    NOR marche (prouvee) mais le port des lampes n'est plus ecrit apres relance.
    Attribution par diff des synthetiques (seuls grant/grant_ms ajoutes).
    Trois pistes ordonnees dans le commentaire, mecanisme encore inconnu.
    [SYS80.vhd]
2026-09-12 README in English, NOTICE provenance settled, link header corrected
    - README.md rewritten in English for the people receiving boards (Ralf);
    the French text moves to README.fr.md unchanged.
    - NOTICE: the lisyctrl/spi_slave/disp80b_diag provenance caveat is closed
    with git evidence (8171c05 on an unmodified upstream; none of the files
    exist in bontango's trees), the modules added since July are listed
    (game_beacon, audio_uart, lib_portable, the Spartan constraints and build
    script, the two-bank EEprom), and section 4 now says where the tree is
    published instead of saying it is not.
    - sound_link.vhd header no longer claims the link drives the Debug pin on
    the Smart FA (it is P142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
    [sound_link.vhd]
